JohannesKienle/Messgeraet/Hardware/Ver1/Analogeingaenge.png

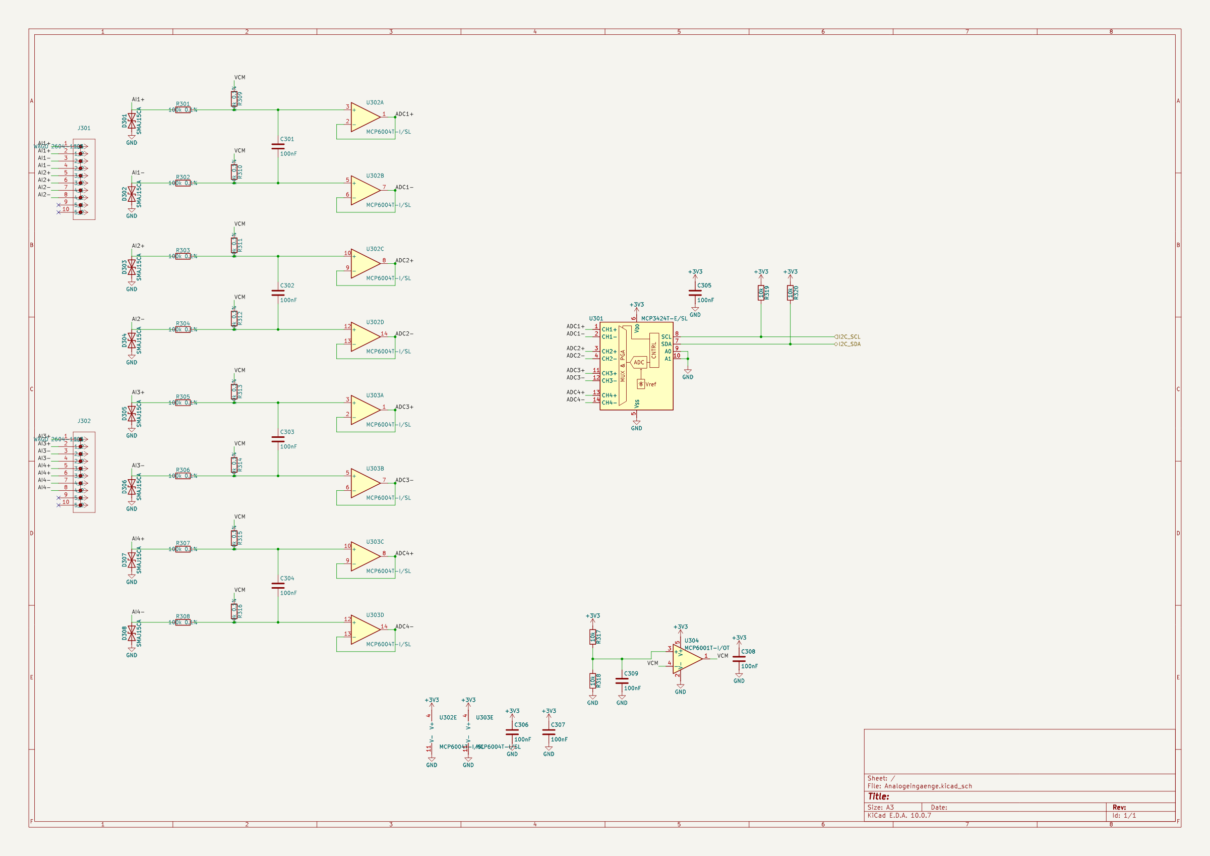
Hardware/Ver1/Analogeingaenge.png
