JohannesKienle/Messgeraet/Hardware/Ver1/Netzspannung.png

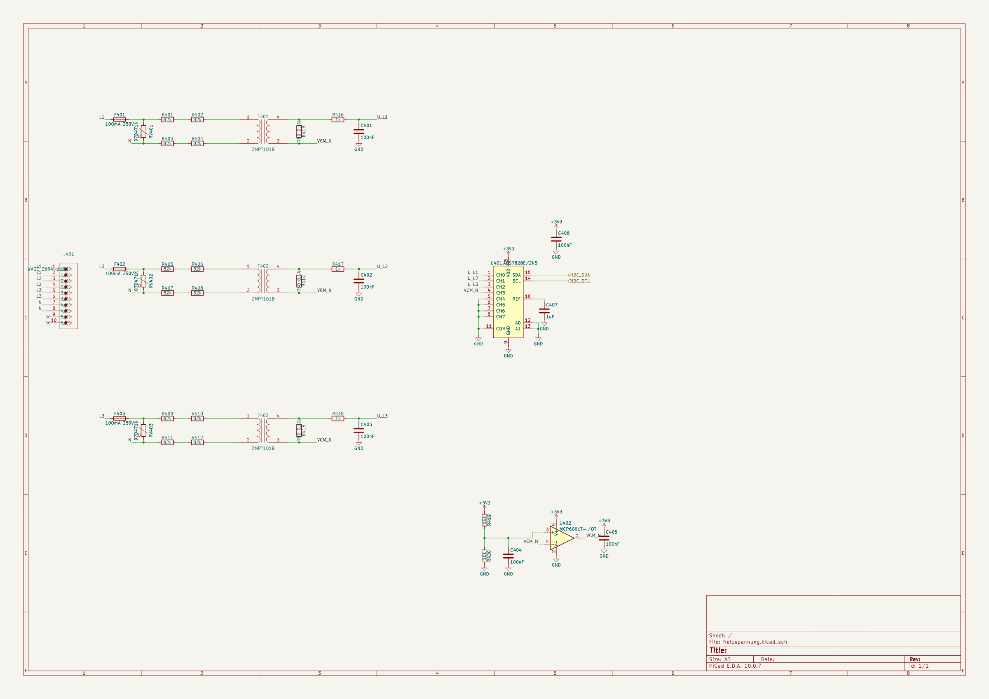
Hardware/Ver1/Netzspannung.png
