JohannesKienle/Messgeraet/Hardware/Ver1/Versorgung.png

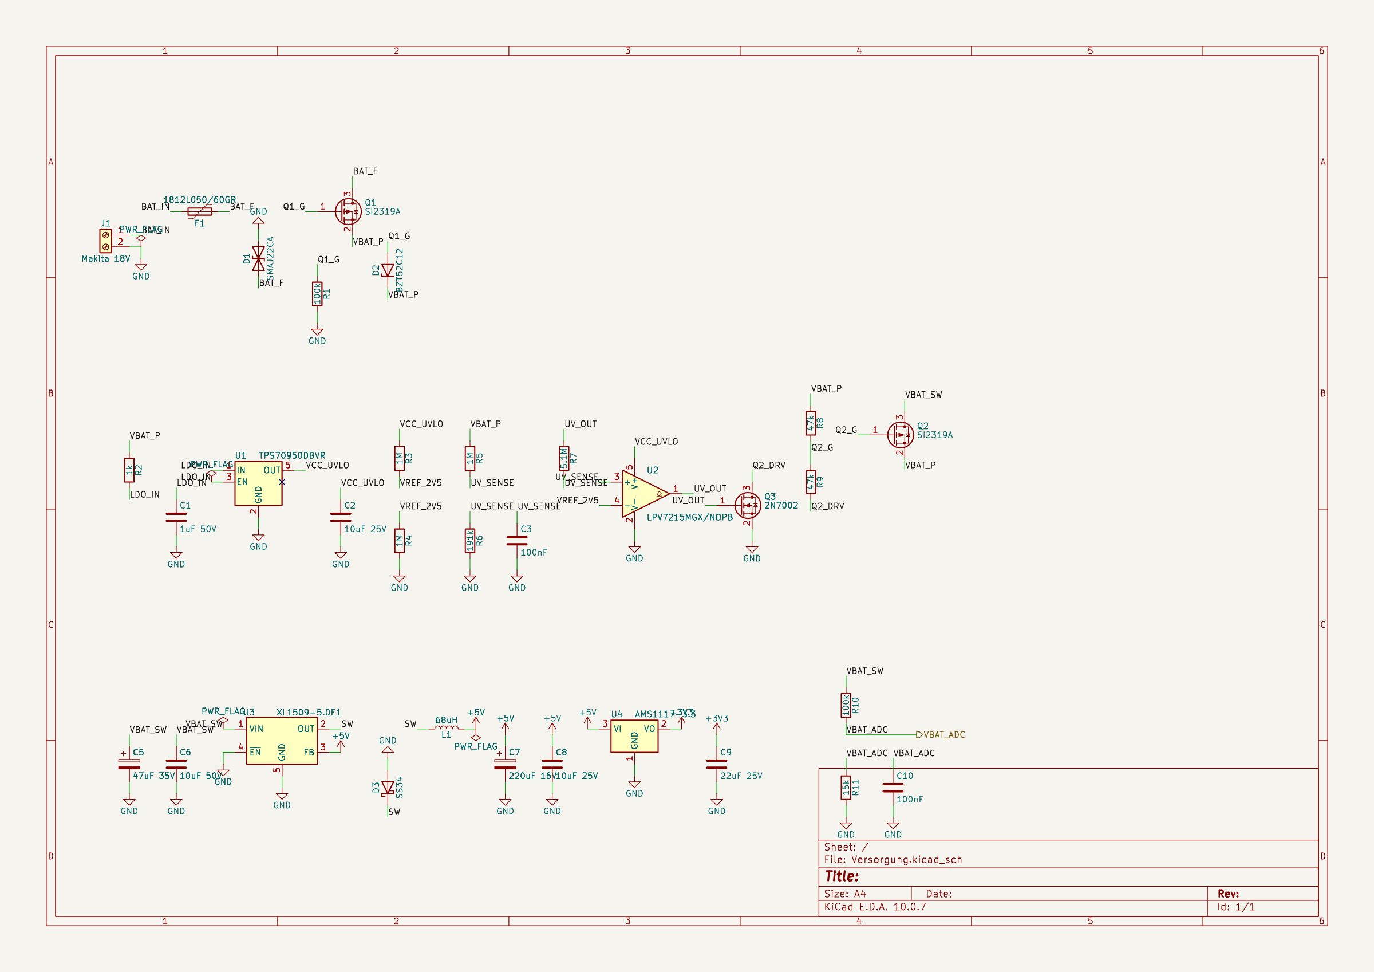
Hardware/Ver1/Versorgung.png
