JohannesKienle/Messgeraet/Hardware/Ver1/production/bom.csv

Designator | Footprint | Quantity | Value | LCSC Part #
C1, C101 | 0805 | 2 | 1uF 50V | C28323
C10, C103, C105, C205, C206, C207, C208, C3, C301, C302, C303, C304, C305, C306, C307, C308, C309, C401, C402, C403, C404, C405, C406, C407 | 0805 | 24 | 100nF | C49678
C102, C9 | 0805 | 2 | 22uF 25V | C45783
C104, C2, C8 | 0805 | 3 | 10uF 25V | C15850
C11 | CP_EIA-3528-21_Kemet-B | 1 | 22uF 10V Tantal | C7198
C201, C202, C203, C204 | 0805 | 4 | 10nF 50V | C1710
C5 | CP_Radial_D6.3mm_P2.50mm | 1 | 47uF 50V | C106605
C6 | 0805 | 1 | 10uF 50V | C440198
C7 | CP_Elec_6.3x7.7 | 1 | 220uF 16V | C178534
D1 | D_SMA | 1 | SMAJ22CA | C113961
D2 | D_SOD-123 | 1 | BZT52C12 | C43491
D201, D202, D203, D204 | D_SMA | 4 | SMAJ30CA | C83322
D205, D206, D207, D208 | 0805 | 4 | gelb | C2296
D3 | D_SMA | 1 | SS34 | C8678
D301, D302, D303, D304, D305, D306, D307, D308 | D_SMA | 8 | SMAJ26CA | C148226
F1 | 1812 | 1 | 1812L050/60GR | C19078719
F401, F402, F403 | Fuse_2410_JDT_JFC2410 | 3 | 100mA 250V | C48686858
J1 | TestPoint_2Pads_Pitch5.08mm_Drill1.3mm | 1 | Makita 18V
J101 | USB_C_Receptacle_HRO_TYPE-C-31-M-12 | 1 | USB-C | C165948
J102 | microSD_HC_Hirose_DM3AT-SF-PEJM5 | 1 | DM3AT-SF-PEJM5 | C114218
J201, J301, J302, J401 | CONN5_2604-1105_WAG | 4 | WAGO 2604-1105 | WAGO 2604-1105
L1 | L_Sunlord_SWPA8040S | 1 | 68uH | C36418
Q1, Q2 | SOT-23 | 2 | SI2319A | C545576
Q3 | SOT-23 | 1 | 2N7002 | C8545
R1, R10 | 0805 | 2 | 100k | C149504
R101, R102, R105, R106, R107, R108, R109, R110, R317, R318, R420 | 0805 | 11 | 10k | C17414
R103, R104 | 0805 | 2 | 5.1k | C27834
R11, R419 | 0805 | 2 | 15k | C17475
R2, R201, R202, R203, R204, R416, R417, R418 | 0805 | 8 | 1k | C17513
R205, R206, R207, R208 | 0805 | 4 | 562 1% | C17755
R209, R210, R211, R212 | 0805 | 4 | 680 | C17798
R3, R4, R5 | 0805 | 3 | 1M | C17514
R301, R302, R303, R304, R305, R306, R307, R308 | 0805 | 8 | 100k 0.1% | C122537
R309, R310, R311, R312, R313, R314, R315, R316 | 0805 | 8 | 10k 0.1% | C110775
R319, R320 | 0805 | 2 | 4.7k | C17673
R401, R402, R403, R404, R405, R406, R407, R408, R409, R410, R411, R412 | 1206 | 12 | 56k | C18029
R413, R414, R415 | 0805 | 3 | 510 0.1% | C309660
R6 | 0805 | 1 | 191k | C17511
R7 | 0805 | 1 | 5.1M | C26114
R8, R9 | 0805 | 2 | 47k | C17713
RV401, RV402, RV403 | RV_Disc_D7mm_W3.4mm_P5mm | 3 | 07D471K | C28756
SW101 | SW_Push_1P1T_XKB_TS-1187A | 1 | RESET | C318884
SW102 | SW_Push_1P1T_XKB_TS-1187A | 1 | BOOT | C318884
T401, T402, T403 | Transformer_Zeming_ZMPT101K | 3 | ZMPT101B | C111858
U1 | SOT-23-5 | 1 | TPS70950DBVR | C96028
U101 | ESP32-S3-WROOM-1 | 1 | ESP32-S3-WROOM-1-N16R8 | C2913202
U102 | SOT-23-6 | 1 | USBLC6-2SC6 | C2687116
U2 | SOT-353_SC-70-5 | 1 | LPV7215MGX/NOPB | C2878861
U201, U202, U203, U204 | SOIC-8_3.9x4.9mm_P1.27mm | 4 | ISO1211DR | C2674102
U3 | SOIC-8_3.9x4.9mm_P1.27mm | 1 | XL1509-5.0E1 | C61063
U301 | SOIC-14_3.9x8.7mm_P1.27mm | 1 | MCP3424T-E/SL | C626769
U302, U303 | SOIC-14_3.9x8.7mm_P1.27mm | 2 | MCP6004T-I/SL | C7378
U304, U402 | SOT-23-5 | 2 | MCP6001T-I/OT | C116490
U4 | SOT-223-3_TabPin2 | 1 | AMS1117-3.3 | C6186
U401 | TSSOP-16_4.4x5mm_P0.65mm | 1 | ADS7828E/2K5 | C701649
