JohannesKienle/Messgeraet/Hardware/Ver1/Manufacturing/Ver1.csv

Id | Designator | Footprint | Quantity | Designation | Supplier and ref
1 | C1, C101 | C_0805_2012Metric | 2 | 1uF 50V
2 | C2, C8, C104 | C_0805_2012Metric | 3 | 10uF 25V
3 | C3, C10, C103, C105, C205, C206, C207, C208, C301, C302, C303, C304, C305, C306, C307, C308, C309, C401, C402, C403, C404, C405, C406, C407 | C_0805_2012Metric | 24 | 100nF
4 | C5 | CP_Radial_D6.3mm_P2.50mm | 1 | 47uF 50V
5 | C6 | C_0805_2012Metric | 1 | 10uF 50V
6 | C7 | CP_Elec_6.3x7.7 | 1 | 220uF 16V
7 | C9, C102 | C_0805_2012Metric | 2 | 22uF 25V
8 | C11 | CP_EIA-3528-21_Kemet-B | 1 | 22uF 10V Tantal
9 | C201, C202, C203, C204 | C_0805_2012Metric | 4 | 10nF 50V
10 | D1 | D_SMA | 1 | SMAJ22CA
11 | D2 | D_SOD-123 | 1 | BZT52C12
12 | D3 | D_SMA | 1 | SS34
13 | D201, D202, D203, D204 | D_SMA | 4 | SMAJ30A
14 | D205, D206, D207, D208 | LED_0805_2012Metric | 4 | gelb
15 | D301, D302, D303, D304, D305, D306, D307, D308 | D_SMA | 8 | SMAJ26CA
16 | F1 | Fuse_1812_4532Metric | 1 | 1812L050/60GR
17 | F401, F402, F403 | Fuse_2410_JDT_JFC2410 | 3 | 100mA 250V
18 | J1 | TestPoint_2Pads_Pitch5.08mm_Drill1.3mm | 1 | Makita 18V
19 | J101 | USB_C_Receptacle_HRO_TYPE-C-31-M-12 | 1 | USB-C
20 | J102 | microSD_HC_Hirose_DM3AT-SF-PEJM5 | 1 | DM3AT-SF-PEJM5
21 | J201, J301, J302, J401 | CONN5_2604-1105_WAG | 4 | WAGO 2604-1105
22 | L1 | L_Sunlord_SWPA8040S | 1 | 68uH
23 | Q1, Q2 | SOT-23 | 2 | SI2319A
24 | Q3 | SOT-23 | 1 | 2N7002
25 | R1, R10 | R_0805_2012Metric | 2 | 100k
26 | R2, R201, R202, R203, R204, R416, R417, R418 | R_0805_2012Metric | 8 | 1k
27 | R3, R4, R5 | R_0805_2012Metric | 3 | 1M
28 | R6 | R_0805_2012Metric | 1 | 191k
29 | R7 | R_0805_2012Metric | 1 | 5.1M
30 | R8, R9 | R_0805_2012Metric | 2 | 47k
31 | R11, R419 | R_0805_2012Metric | 2 | 15k
32 | R101, R102, R105, R106, R107, R108, R109, R110, R317, R318, R420 | R_0805_2012Metric | 11 | 10k
33 | R103, R104 | R_0805_2012Metric | 2 | 5.1k
34 | R205, R206, R207, R208 | R_0805_2012Metric | 4 | 562 1%
35 | R209, R210, R211, R212 | R_0805_2012Metric | 4 | 680
36 | R301, R302, R303, R304, R305, R306, R307, R308 | R_0805_2012Metric | 8 | 100k 0.1%
37 | R309, R310, R311, R312, R313, R314, R315, R316 | R_0805_2012Metric | 8 | 10k 0.1%
38 | R319, R320 | R_0805_2012Metric | 2 | 4.7k
39 | R401, R402, R403, R404, R405, R406, R407, R408, R409, R410, R411, R412 | R_1206_3216Metric | 12 | 82k
40 | R413, R414, R415 | R_0805_2012Metric | 3 | 750 0.1%
41 | RV401, RV402, RV403 | RV_Disc_D7mm_W3.4mm_P5mm | 3 | 07D471K
42 | SW101 | SW_Push_1P1T_XKB_TS-1187A | 1 | RESET
43 | SW102 | SW_Push_1P1T_XKB_TS-1187A | 1 | BOOT
44 | T401, T402, T403 | Transformer_Zeming_ZMPT101K | 3 | ZMPT101B
45 | U1 | SOT-23-5 | 1 | TPS70950DBVR
46 | U2 | SOT-353_SC-70-5 | 1 | LPV7215MGX/NOPB
47 | U3 | SOIC-8_3.9x4.9mm_P1.27mm | 1 | XL1509-5.0E1
48 | U4 | SOT-223-3_TabPin2 | 1 | AMS1117-3.3
49 | U101 | ESP32-S3-WROOM-1 | 1 | ESP32-S3-WROOM-1-N16R8
50 | U102 | SOT-23-6 | 1 | USBLC6-2SC6
51 | U201, U202, U203, U204 | SOIC-8_3.9x4.9mm_P1.27mm | 4 | ISO1211DR
52 | U301 | SOIC-14_3.9x8.7mm_P1.27mm | 1 | MCP3424T-E/SL
53 | U302, U303 | SOIC-14_3.9x8.7mm_P1.27mm | 2 | MCP6004T-I/SL
54 | U304, U402 | SOT-23-5 | 2 | MCP6001T-I/OT
55 | U401 | TSSOP-16_4.4x5mm_P0.65mm | 1 | ADS7828E/2K5
