JohannesKienle/Messgeraet/Hardware/Ver1/KiCADv6/2604-1105.stp

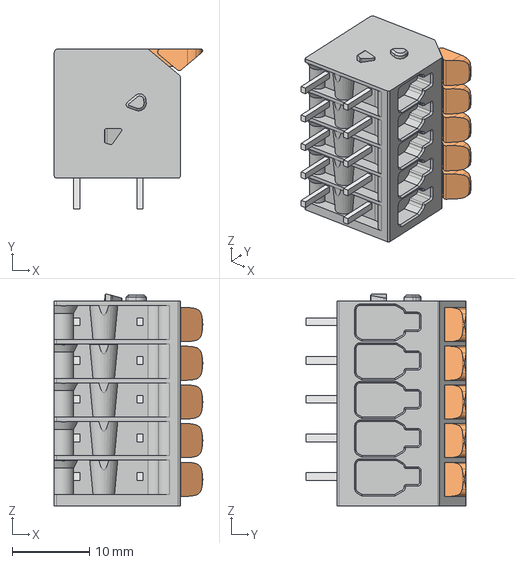
[picture p4: CAD file, 2026-11-12]
Hardware/Ver1/KiCADv6/2604-1105.stp
19.2 x 20.7 x 27.4 mm
