JohannesKienle/Messgeraet/Hardware/Ver1/Ver1.step

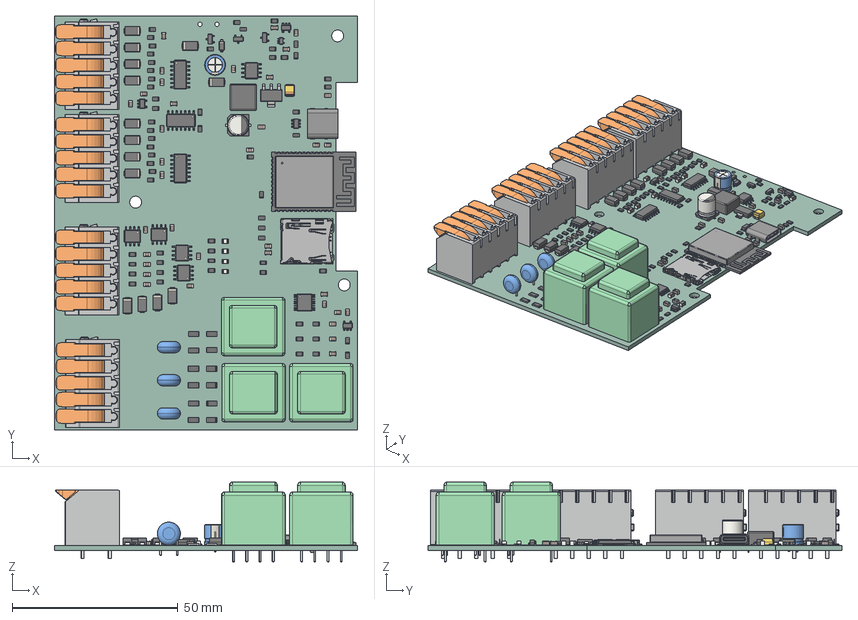
[picture p5: CAD file, 2026-11-12]
Hardware/Ver1/Ver1.step
91.5 x 125.0 x 24.1 mm
C_0805_2012Metric x 36
R_0805_2012Metric x 61
R_1206_3216Metric x 12
ESP32-S3-WROOM-1
SOT-353_SC-70-5
D_SMA x 14
SOIC-14_3.9x8.7mm_P1.27mm x 3
RV_Disc_D7mm_W34mm_P5mm x 3
Transformer_Breve_TEZ_22x025 x 3
Transformer_Breve_TEZ_22x24 x 3
CP_Elec_63x77
SOT-23-5 x 3
LED_0805_2012Metric x 4
SOIC-8_3.9x4.9mm_P1.27mm x 5
USB_C_Receptacle_GCT_USB4085
SOT-23 x 3
SOT-223
a6ca55be-8551-11ed-a139-00155d22e2d7_part
a6ca56f4-8551-11ed-a139-00155d22e2d7_part
a6ca5776-8551-11ed-a139-00155d22e2d7_part
CP_EIA_3528_21_Kemet_B
TSSOP-16_4.4x5mm_P0.65mm
microSD_HC_Hirose_DM3AT-SF-PEJM5
D_SOD-123
SOT-23-6
CP_Radial_D63mm_P250mm
Ver81F1_PCB
