JohannesKienle/Messgeraet/Hardware/Ver1/Ver1.kicad_pcb

## KiCad design Hardware/Ver1/Ver1.kicad_pcb (2026-11-12)

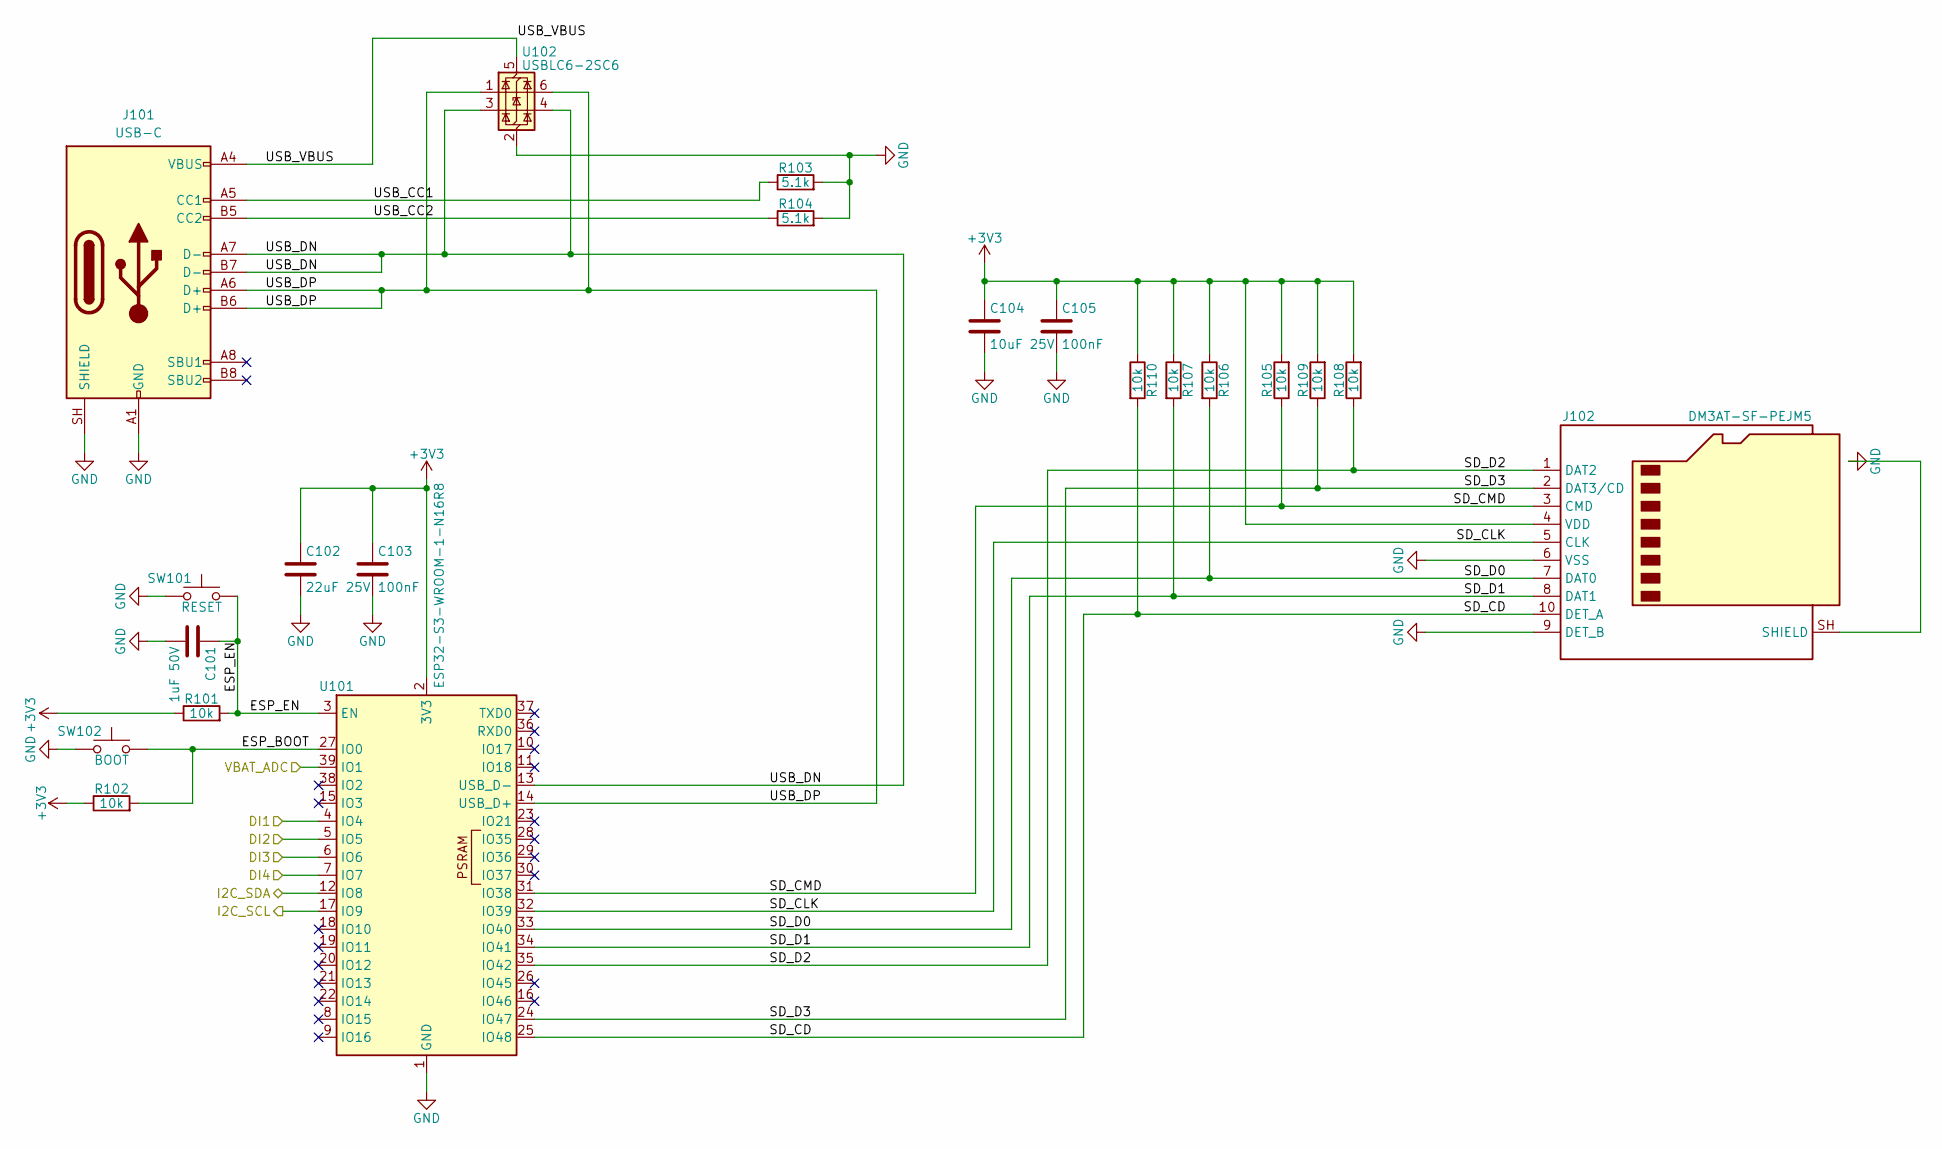
[picture p6: schematic ESP32.kicad_sch]

Parts:
C101: 1uF 50V; C_0805_2012Metric; MPN CL21B105KBFNNNE; LCSC C28323
C102: 22uF 25V; C_0805_2012Metric; MPN CL21A226MAQNNNE; LCSC C45783
C103, C105: 100nF; C_0805_2012Metric; MPN CC0805KRX7R9BB104; LCSC C49678
C104: 10uF 25V; C_0805_2012Metric; MPN CL21A106KAYNNNE; LCSC C15850
J101: USB-C; USB_C_Receptacle_HRO_TYPE-C-31-M-12; MPN TYPE-C-31-M-12; LCSC C165948
J102: DM3AT-SF-PEJM5; microSD_HC_Hirose_DM3AT-SF-PEJM5; MPN DM3AT-SF-PEJM5; LCSC C114218
R101, R102, R105, R106, R107, R108, R109, R110: 10k; R_0805_2012Metric; MPN 0805W8F1002T5E; LCSC C17414
R103, R104: 5.1k; R_0805_2012Metric; MPN 0805W8F5101T5E; LCSC C27834
SW101: RESET; SW_Push_1P1T_XKB_TS-1187A; MPN TS-1187A-B-A-B; LCSC C318884
SW102: BOOT; SW_Push_1P1T_XKB_TS-1187A; MPN TS-1187A-B-A-B; LCSC C318884
U101: ESP32-S3-WROOM-1-N16R8; ESP32-S3-WROOM-1; MPN ESP32-S3-WROOM-1-N16R8; LCSC C2913202
U102: USBLC6-2SC6; SOT-23-6; MPN USBLC6-2SC6; LCSC C2687116

Connections:
+3V3: C102.1, C103.1, C104.1, C105.1, J102.4 (VDD), R101.1, R102.1, R105.2, R106.1, R107.1, R108.2, R109.2, R110.1, U101.2 (3V3); also elsewhere on the board
/Analogeingänge/I2C_SCL: U101.17 (IO9); also elsewhere on the board
/Analogeingänge/I2C_SDA: U101.12 (IO8); also elsewhere on the board
/Digitaleingänge/DI1: U101.4 (IO4); also elsewhere on the board
/Digitaleingänge/DI2: U101.5 (IO5); also elsewhere on the board
/Digitaleingänge/DI3: U101.6 (IO6); also elsewhere on the board
/Digitaleingänge/DI4: U101.7 (IO7); also elsewhere on the board
/ESP32/ESP_BOOT: R102.2, SW102.1, U101.27 (IO0)
/ESP32/ESP_EN: C101.1, R101.2, SW101.1, U101.3 (EN)
/ESP32/SD_CD: J102.10 (DET_A), R110.2, U101.25 (IO48)
/ESP32/SD_CLK: J102.5 (CLK), U101.32 (IO39)
/ESP32/SD_CMD: J102.3 (CMD), R105.1, U101.31 (IO38)
/ESP32/SD_D0: J102.7 (DAT0), R106.2, U101.33 (IO40)
/ESP32/SD_D1: J102.8 (DAT1), R107.2, U101.34 (IO41)
/ESP32/SD_D2: J102.1 (DAT2), R108.1, U101.35 (IO42)
/ESP32/SD_D3: J102.2 (DAT3/CD), R109.1, U101.24 (IO47)
/ESP32/USB_CC1: J101.A5 (CC1), R103.1
/ESP32/USB_CC2: J101.B5 (CC2), R104.1
/ESP32/USB_DN: J101.A7 (D-), J101.B7 (D-), U101.13 (USB_D-), U102.3 (I/O2), U102.4 (I/O2)
/ESP32/USB_DP: J101.A6 (D+), J101.B6 (D+), U101.14 (USB_D+), U102.1 (I/O1), U102.6 (I/O1)
/ESP32/USB_VBUS: J101.A4 (VBUS), J101.A9 (VBUS), J101.B4 (VBUS), J101.B9 (VBUS), U102.5 (VBUS)
/Versorgung/VBAT_ADC: U101.39 (IO1); also elsewhere on the board

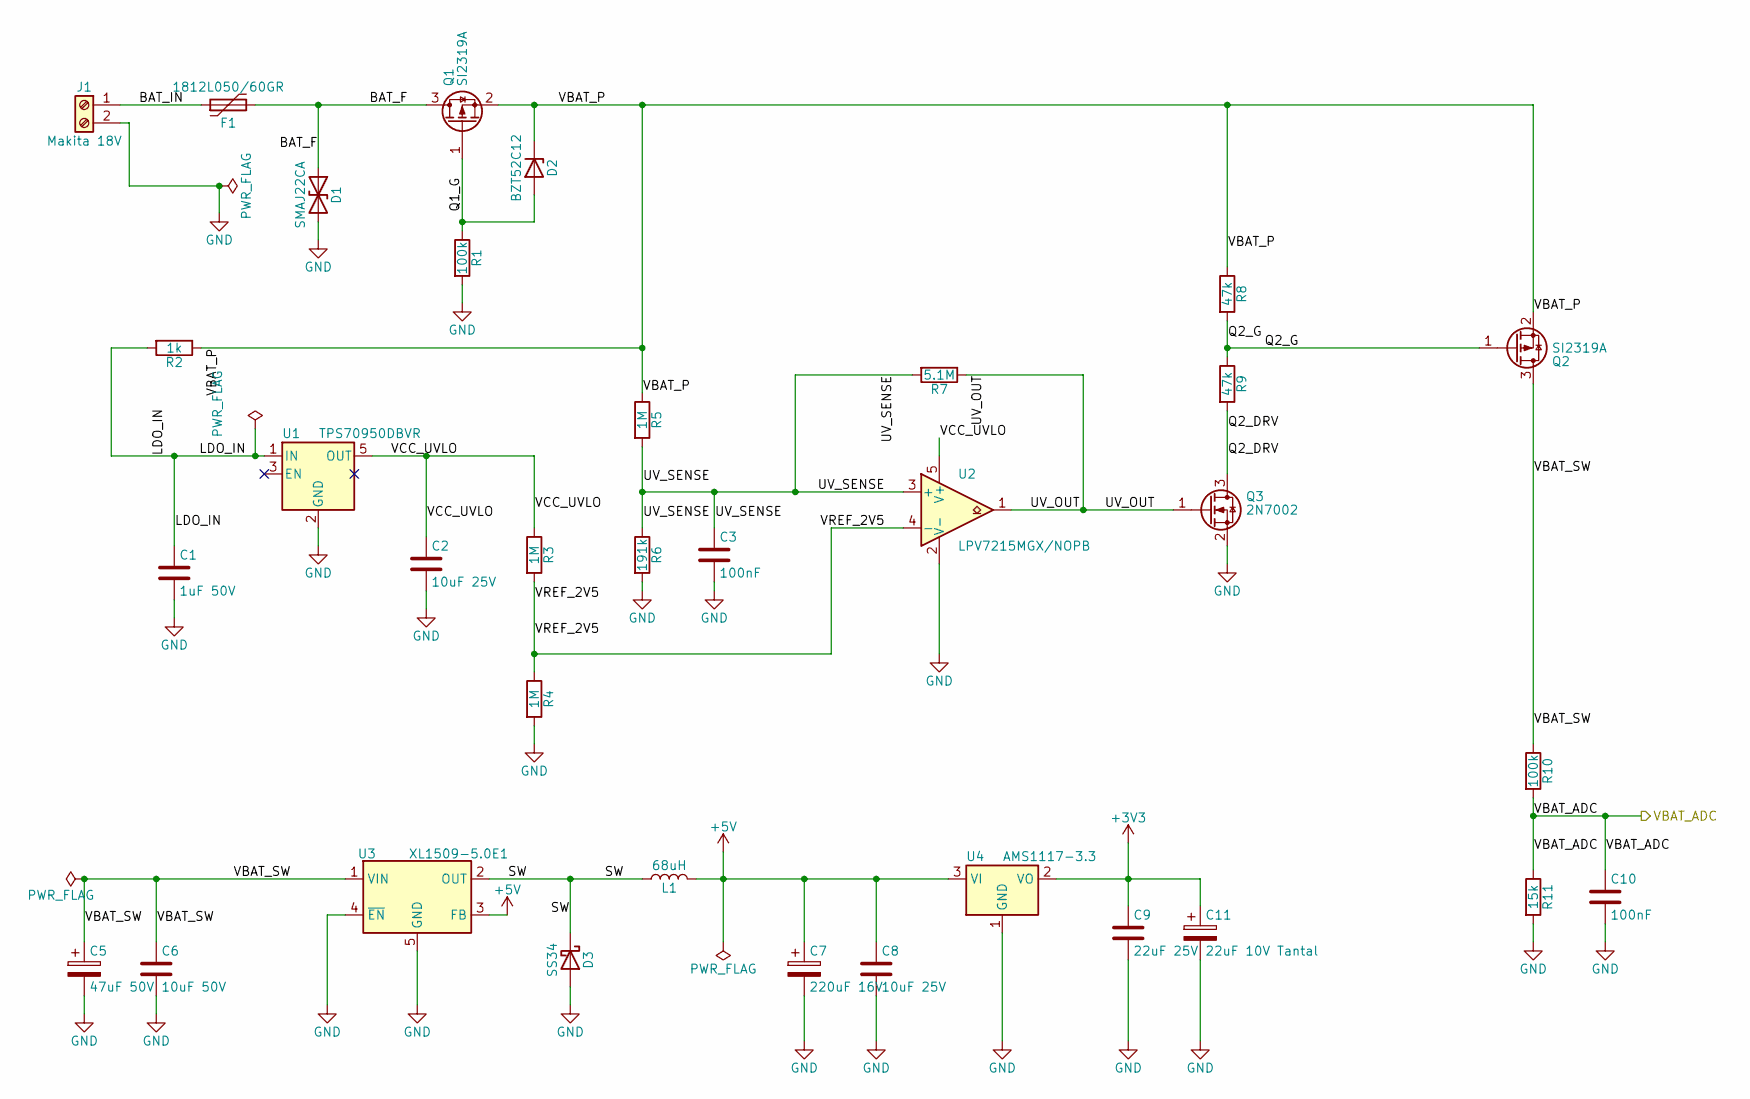
[picture p7: schematic Versorgung.kicad_sch]

Parts:
C1: 1uF 50V; C_0805_2012Metric; MPN CL21B105KBFNNNE; LCSC C28323
C2, C8: 10uF 25V; C_0805_2012Metric; MPN CL21A106KAYNNNE; LCSC C15850
C3, C10: 100nF; C_0805_2012Metric; MPN CC0805KRX7R9BB104; LCSC C49678
C5: 47uF 50V; CP_Radial_D6.3mm_P2.50mm; MPN ERM1HM470E11OT; LCSC C106605
C6: 10uF 50V; C_0805_2012Metric; MPN GRM21BR61H106KE43L; LCSC C440198
C7: 220uF 16V; CP_Elec_6.3x7.7; MPN EEEFK1C221P; LCSC C178534
C9: 22uF 25V; C_0805_2012Metric; MPN CL21A226MAQNNNE; LCSC C45783
C11: 22uF 10V Tantal; CP_EIA-3528-21_Kemet-B; MPN TAJB226K010RNJ; LCSC C7198
D1: SMAJ22CA; D_SMA; MPN SMAJ22CA; LCSC C113961
D2: BZT52C12; D_SOD-123; MPN BZT52C12; LCSC C43491
D3: SS34; D_SMA; MPN SS34; LCSC C8678
F1: 1812L050/60GR; Fuse_1812_4532Metric; MPN 1812L050/60GR; LCSC C19078719
J1: Makita 18V; TestPoint_2Pads_Pitch5.08mm_Drill1.3mm
L1: 68uH; L_Sunlord_SWPA8040S; MPN SWPA8040S680MT; LCSC C36418
Q1, Q2: SI2319A; SOT-23; MPN SI2319A; LCSC C545576
Q3: 2N7002; SOT-23; MPN 2N7002; LCSC C8545
R1, R10: 100k; R_0805_2012Metric; MPN 0805W8F1003T5E; LCSC C149504
R2: 1k; R_0805_2012Metric; MPN 0805W8F1001T5E; LCSC C17513
R3, R4, R5: 1M; R_0805_2012Metric; MPN 0805W8F1004T5E; LCSC C17514
R6: 191k; R_0805_2012Metric; MPN 0805W8F1913T5E; LCSC C17511
R7: 5.1M; R_0805_2012Metric; MPN 0805W8F5104T5E; LCSC C26114
R8, R9: 47k; R_0805_2012Metric; MPN 0805W8F4702T5E; LCSC C17713
R11: 15k; R_0805_2012Metric; MPN 0805W8F1502T5E; LCSC C17475
U1: TPS70950DBVR; SOT-23-5; MPN TPS70950DBVR; LCSC C96028
U2: LPV7215MGX/NOPB; SOT-353_SC-70-5; MPN LPV7215MGX/NOPB; LCSC C2878861
U3: XL1509-5.0E1; SOIC-8_3.9x4.9mm_P1.27mm; MPN XL1509-5.0E1; LCSC C61063
U4: AMS1117-3.3; SOT-223-3_TabPin2; MPN AMS1117-3.3; LCSC C6186

Connections:
+3V3: C9.1, C11.1, U4.2 (VO); also elsewhere on the board
/Versorgung/BAT_F: D1.1 (A1), F1.2, Q1.3 (D)
/Versorgung/BAT_IN: F1.1, J1.1
/Versorgung/Q1_G: D2.2 (A), Q1.1 (G), R1.1
/Versorgung/Q2_DRV: Q3.3 (D), R9.2
/Versorgung/Q2_G: Q2.1 (G), R8.2, R9.1
/Versorgung/SW: D3.1 (K), L1.1, U3.2 (OUT)
/Versorgung/UV_OUT: Q3.1 (G), R7.1, U2.1
/Versorgung/UV_SENSE: C3.1, R5.2, R6.1, R7.2, U2.3 (+)
/Versorgung/VBAT_ADC: C10.1, R10.2, R11.1; also elsewhere on the board
/Versorgung/VBAT_P: D2.1 (K), Q1.2 (S), Q2.2 (S), R2.1, R5.1, R8.1
/Versorgung/VCC_UVLO: C2.1, R3.1, U1.5 (OUT), U2.5 (V+)
/Versorgung/VREF_2V5: R3.2, R4.1, U2.4 (-)

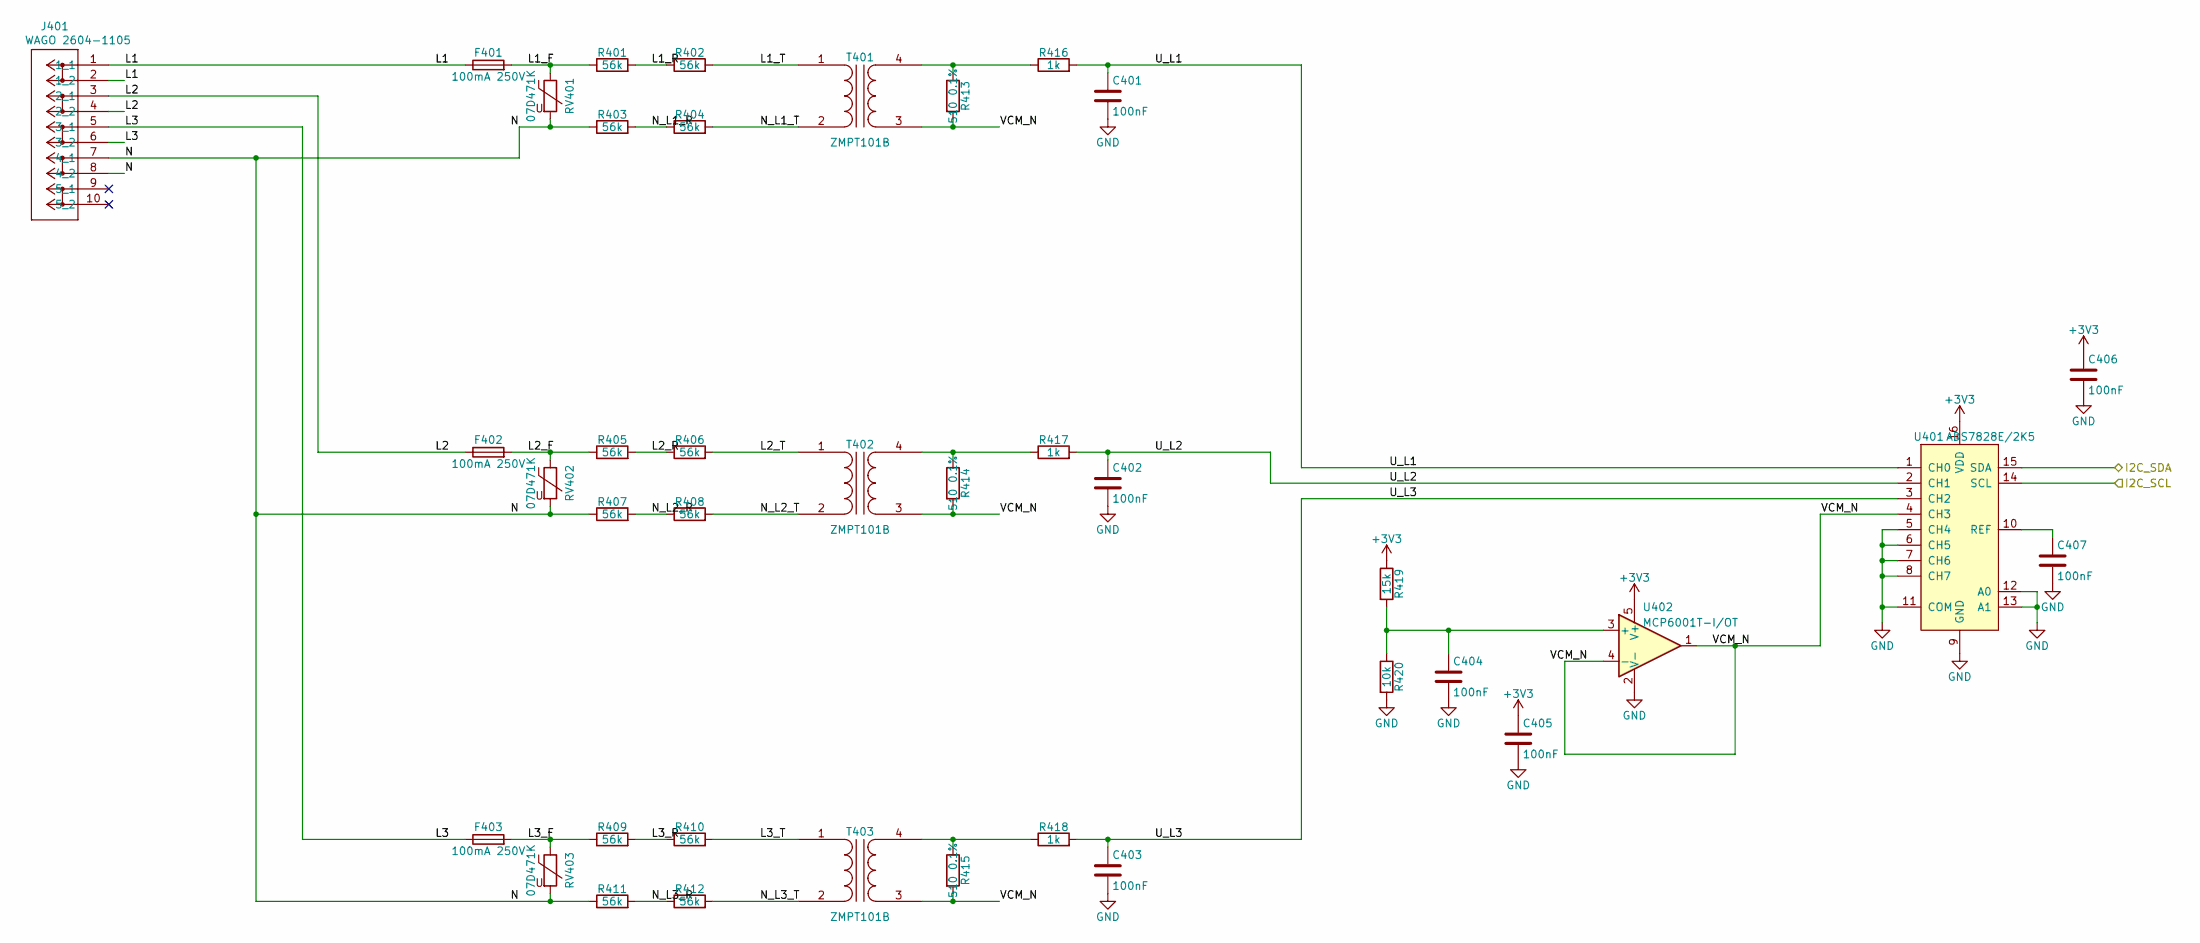
[picture p8: schematic Netzspannung.kicad_sch]

Parts:
C401, C402, C403, C404, C405, C406, C407: 100nF; C_0805_2012Metric; MPN CC0805KRX7R9BB104; LCSC C49678
F401, F402, F403: 100mA 250V; Fuse_2410_JDT_JFC2410; MPN JFC2410-0100FS; LCSC C48686858
J401: WAGO 2604-1105; CONN5_2604-1105_WAG; MPN WAGO 2604-1105
R401, R402, R403, R404, R405, R406, R407, R408, R409, R410, R411, R412: 56k; R_1206_3216Metric; MPN 1206W4F5602T5E; LCSC C18029
R413, R414, R415: 510 0.1%; R_0805_2012Metric; MPN RT0805BRD07510RL; LCSC C309660
R416, R417, R418: 1k; R_0805_2012Metric; MPN 0805W8F1001T5E; LCSC C17513
R419: 15k; R_0805_2012Metric; MPN 0805W8F1502T5E; LCSC C17475
R420: 10k; R_0805_2012Metric; MPN 0805W8F1002T5E; LCSC C17414
RV401, RV402, RV403: 07D471K; RV_Disc_D7mm_W3.4mm_P5mm; MPN 07D471K; LCSC C28756
T401, T402, T403: ZMPT101B; Transformer_Zeming_ZMPT101K; MPN ZMPT101B; LCSC C111858
U401: ADS7828E/2K5; TSSOP-16_4.4x5mm_P0.65mm; MPN ADS7828E/2K5; LCSC C701649
U402: MCP6001T-I/OT; SOT-23-5; MPN MCP6001T-I/OT; LCSC C116490

Connections:
+3V3: C405.1, C406.1, R419.1, U401.16 (VDD), U402.5 (V+); also elsewhere on the board
/Analogeingänge/I2C_SCL: U401.14 (SCL); also elsewhere on the board
/Analogeingänge/I2C_SDA: U401.15 (SDA); also elsewhere on the board
/Netzspannung/L1: F401.1, J401.1 (1_1), J401.2 (1_2)
/Netzspannung/L1_F: F401.2, R401.1, RV401.1
/Netzspannung/L1_R: R401.2, R402.1
/Netzspannung/L1_T: R402.2, T401.1 (AA)
/Netzspannung/L2: F402.1, J401.3 (2_1), J401.4 (2_2)
/Netzspannung/L2_F: F402.2, R405.1, RV402.1
/Netzspannung/L2_R: R405.2, R406.1
/Netzspannung/L2_T: R406.2, T402.1 (AA)
/Netzspannung/L3: F403.1, J401.5 (3_1), J401.6 (3_2)
/Netzspannung/L3_F: F403.2, R409.1, RV403.1
/Netzspannung/L3_R: R409.2, R410.1
/Netzspannung/L3_T: R410.2, T403.1 (AA)
/Netzspannung/N: J401.7 (4_1), J401.8 (4_2), R403.1, R407.1, R411.1, RV401.2, RV402.2, RV403.2
/Netzspannung/N_L1_R: R403.2, R404.1
/Netzspannung/N_L1_T: R404.2, T401.2 (AB)
/Netzspannung/N_L2_R: R407.2, R408.1
/Netzspannung/N_L2_T: R408.2, T402.2 (AB)
/Netzspannung/N_L3_R: R411.2, R412.1
/Netzspannung/N_L3_T: R412.2, T403.2 (AB)
/Netzspannung/U_L1: C401.1, R416.2, U401.1 (CH0)
/Netzspannung/U_L2: C402.1, R417.2, U401.2 (CH1)
/Netzspannung/U_L3: C403.1, R418.2, U401.3 (CH2)
/Netzspannung/VCM_N: R413.2, R414.2, R415.2, T401.3 (SA), T402.3 (SA), T403.3 (SA), U401.4 (CH3), U402.1, U402.4 (-)
unnamed: R413.1, R416.1, T401.4 (SB)
unnamed: R414.1, R417.1, T402.4 (SB)
unnamed: R415.1, R418.1, T403.4 (SB)
unnamed: C407.1, U401.10 (REF)
unnamed: C404.1, R419.2, R420.1, U402.3 (+)

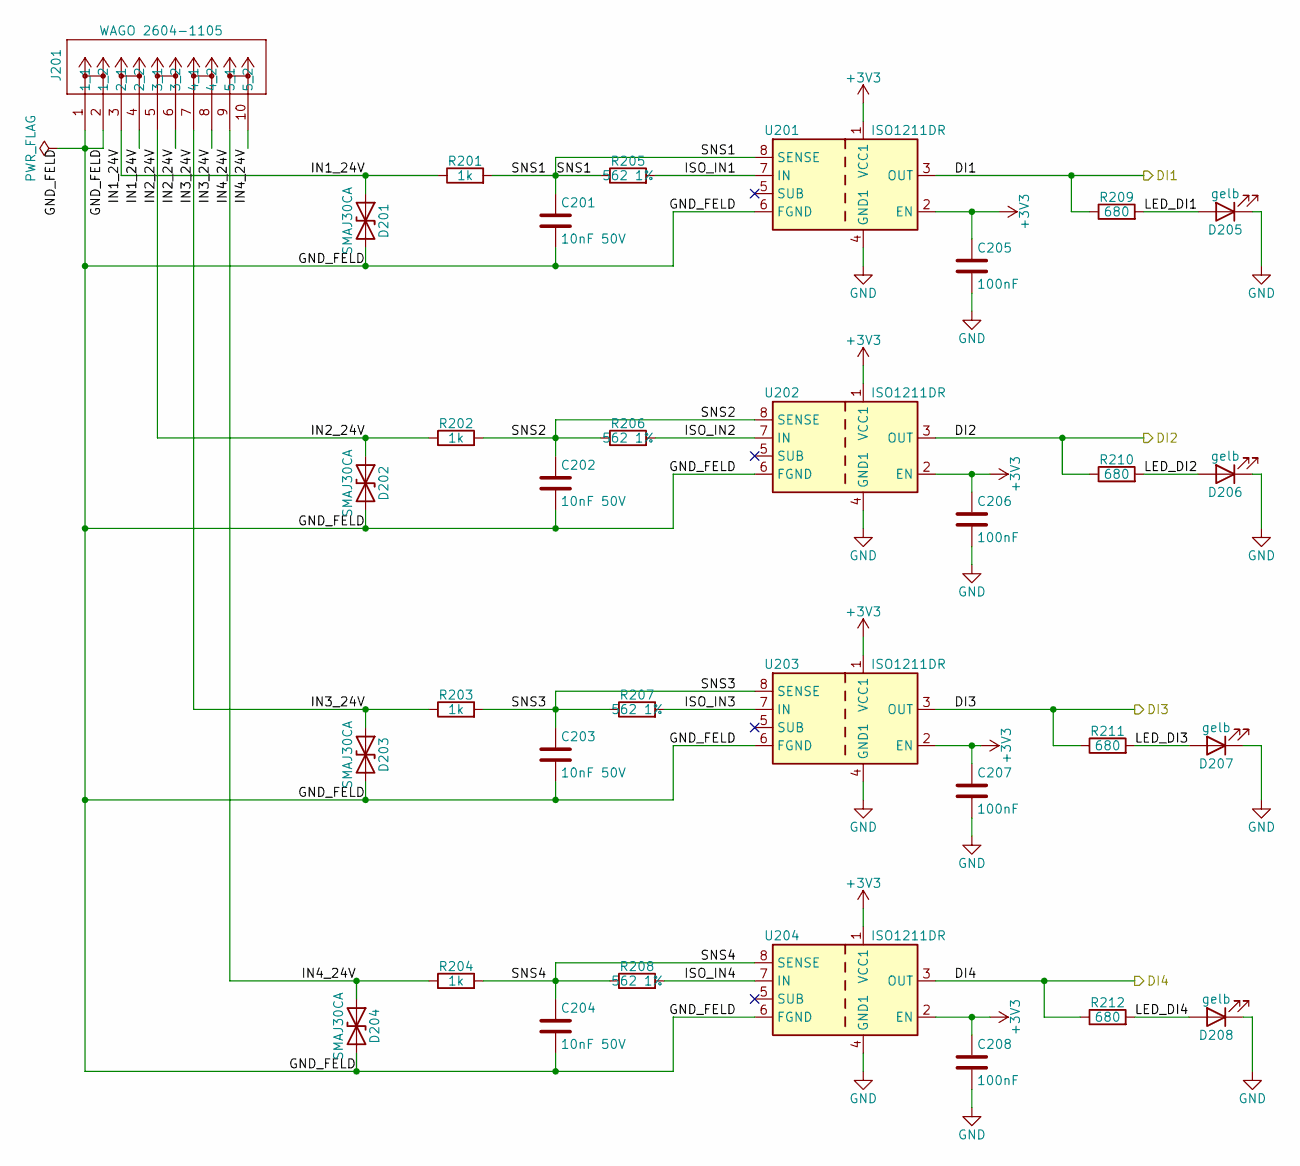
[picture p9: schematic Digitaleingaenge.kicad_sch]

Parts:
C201, C202, C203, C204: 10nF 50V; C_0805_2012Metric; MPN CL21B103KBANNNC; LCSC C1710
C205, C206, C207, C208: 100nF; C_0805_2012Metric; MPN CC0805KRX7R9BB104; LCSC C49678
D201, D202, D203, D204: SMAJ30CA; D_SMA; MPN SMAJ30CA; LCSC C83322
D205, D206, D207, D208: gelb; LED_0805_2012Metric; MPN KT-0805Y; LCSC C2296
J201: WAGO 2604-1105; CONN5_2604-1105_WAG; MPN WAGO 2604-1105
R201, R202, R203, R204: 1k; R_0805_2012Metric; MPN 0805W8F1001T5E; LCSC C17513
R205, R206, R207, R208: 562 1%; R_0805_2012Metric; MPN 0805W8F5620T5E; LCSC C17755
R209, R210, R211, R212: 680; R_0805_2012Metric; MPN 0805W8F6800T5E; LCSC C17798
U201, U202, U203, U204: ISO1211DR; SOIC-8_3.9x4.9mm_P1.27mm; MPN ISO1211DR; LCSC C2674102

Connections:
+3V3: C205.1, C206.1, C207.1, C208.1, U201.1 (VCC1), U201.2 (EN), U202.1 (VCC1), U202.2 (EN), U203.1 (VCC1), U203.2 (EN), U204.1 (VCC1), U204.2 (EN); also elsewhere on the board
/Digitaleingänge/DI1: R209.1, U201.3 (OUT); also elsewhere on the board
/Digitaleingänge/DI2: R210.1, U202.3 (OUT); also elsewhere on the board
/Digitaleingänge/DI3: R211.1, U203.3 (OUT); also elsewhere on the board
/Digitaleingänge/DI4: R212.1, U204.3 (OUT); also elsewhere on the board
/Digitaleingänge/GND_FELD: C201.2, C202.2, C203.2, C204.2, D201.2 (A2), D202.2 (A2), D203.2 (A2), D204.2 (A2), J201.1 (1_1), J201.2 (1_2), U201.6 (FGND), U202.6 (FGND), U203.6 (FGND), U204.6 (FGND)
/Digitaleingänge/IN1_24V: D201.1 (A1), J201.3 (2_1), J201.4 (2_2), R201.1
/Digitaleingänge/IN2_24V: D202.1 (A1), J201.5 (3_1), J201.6 (3_2), R202.1
/Digitaleingänge/IN3_24V: D203.1 (A1), J201.7 (4_1), J201.8 (4_2), R203.1
/Digitaleingänge/IN4_24V: D204.1 (A1), J201.9 (5_1), J201.10 (5_2), R204.1
/Digitaleingänge/ISO_IN1: R205.2, U201.7 (IN)
/Digitaleingänge/ISO_IN2: R206.2, U202.7 (IN)
/Digitaleingänge/ISO_IN3: R207.2, U203.7 (IN)
/Digitaleingänge/ISO_IN4: R208.2, U204.7 (IN)
/Digitaleingänge/LED_DI1: D205.2 (A), R209.2
/Digitaleingänge/LED_DI2: D206.2 (A), R210.2
/Digitaleingänge/LED_DI3: D207.2 (A), R211.2
/Digitaleingänge/LED_DI4: D208.2 (A), R212.2
/Digitaleingänge/SNS1: C201.1, R201.2, R205.1, U201.8 (SENSE)
/Digitaleingänge/SNS2: C202.1, R202.2, R206.1, U202.8 (SENSE)
/Digitaleingänge/SNS3: C203.1, R203.2, R207.1, U203.8 (SENSE)
/Digitaleingänge/SNS4: C204.1, R204.2, R208.1, U204.8 (SENSE)

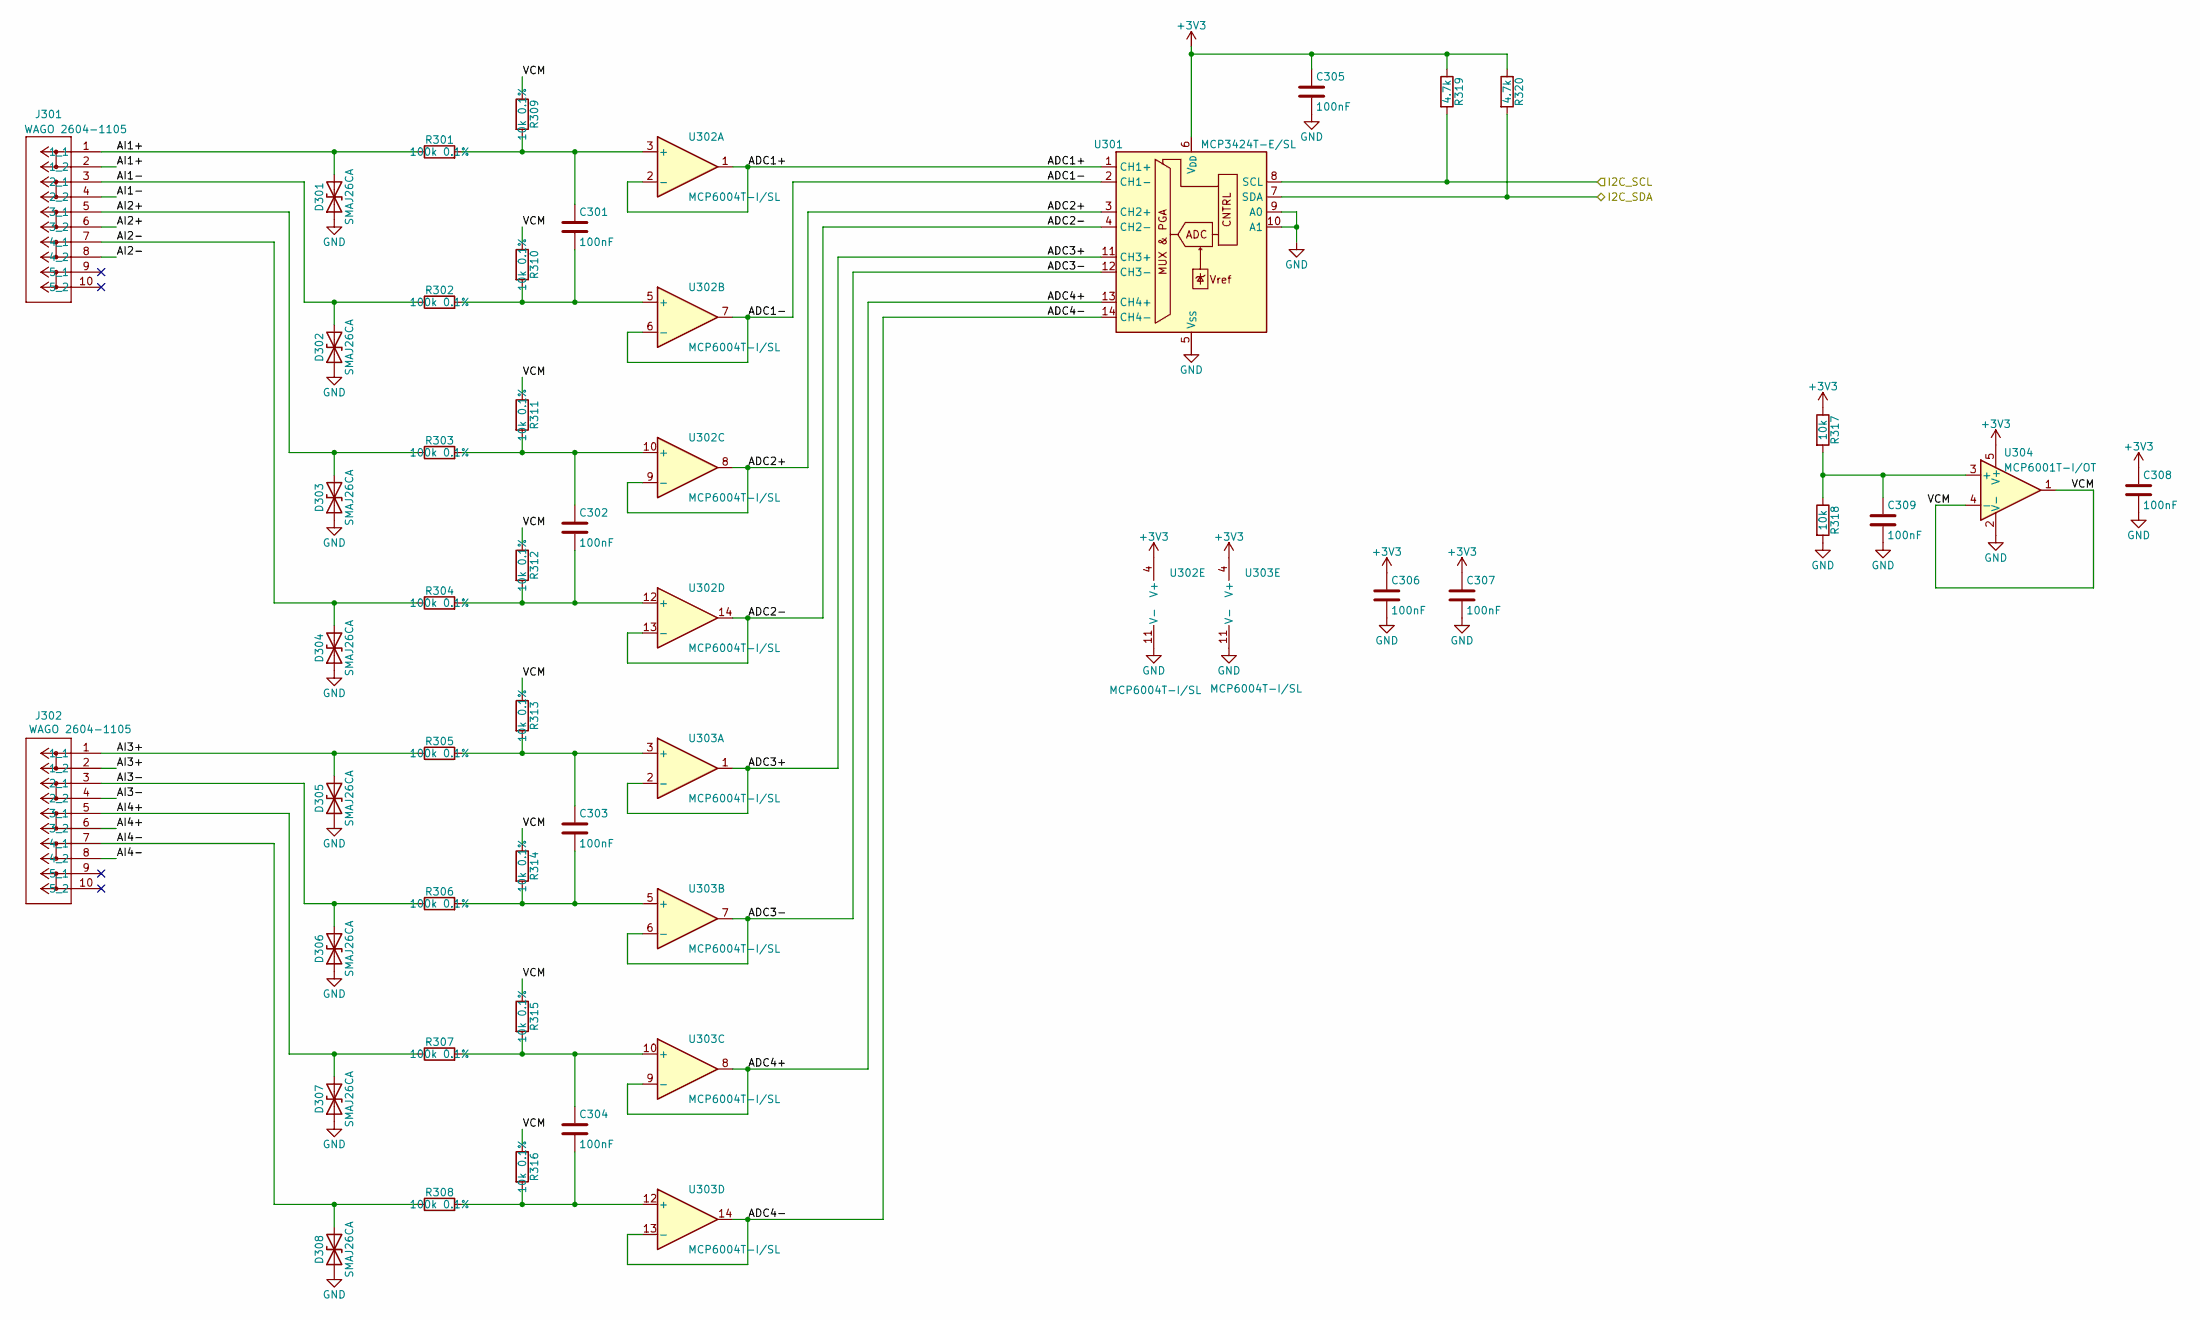
[picture p10: schematic Analogeingaenge.kicad_sch]

Parts:
C301, C302, C303, C304, C305, C306, C307, C308, C309: 100nF; C_0805_2012Metric; MPN CC0805KRX7R9BB104; LCSC C49678
D301, D302, D303, D304, D305, D306, D307, D308: SMAJ26CA; D_SMA; MPN SMAJ26CA; LCSC C148226
J301, J302: WAGO 2604-1105; CONN5_2604-1105_WAG; MPN WAGO 2604-1105
R301, R302, R303, R304, R305, R306, R307, R308: 100k 0.1%; R_0805_2012Metric; MPN RT0805BRD07100KL; LCSC C122537
R309, R310, R311, R312, R313, R314, R315, R316: 10k 0.1%; R_0805_2012Metric; MPN RT0805BRD0710KL; LCSC C110775
R317, R318: 10k; R_0805_2012Metric; MPN 0805W8F1002T5E; LCSC C17414
R319, R320: 4.7k; R_0805_2012Metric; MPN 0805W8F4701T5E; LCSC C17673
U301: MCP3424T-E/SL; SOIC-14_3.9x8.7mm_P1.27mm; MPN MCP3424T-E/SL; LCSC C626769
U302, U303: MCP6004T-I/SL; SOIC-14_3.9x8.7mm_P1.27mm; MPN MCP6004T-I/SL; LCSC C7378
U304: MCP6001T-I/OT; SOT-23-5; MPN MCP6001T-I/OT; LCSC C116490

Connections:
+3V3: C305.1, C306.1, C307.1, C308.1, R317.1, R319.1, R320.1, U301.6 (V_{DD}), U302.4 (V+), U303.4 (V+), U304.5 (V+); also elsewhere on the board
/Analogeingänge/ADC1+: U301.1 (CH1+), U302.1, U302.2 (-)
/Analogeingänge/ADC1-: U301.2 (CH1-), U302.6 (-), U302.7
/Analogeingänge/ADC2+: U301.3 (CH2+), U302.8, U302.9 (-)
/Analogeingänge/ADC2-: U301.4 (CH2-), U302.13 (-), U302.14
/Analogeingänge/ADC3+: U301.11 (CH3+), U303.1, U303.2 (-)
/Analogeingänge/ADC3-: U301.12 (CH3-), U303.6 (-), U303.7
/Analogeingänge/ADC4+: U301.13 (CH4+), U303.8, U303.9 (-)
/Analogeingänge/ADC4-: U301.14 (CH4-), U303.13 (-), U303.14
/Analogeingänge/AI1+: D301.2 (A2), J301.1 (1_1), J301.2 (1_2), R301.1
/Analogeingänge/AI1-: D302.2 (A2), J301.3 (2_1), J301.4 (2_2), R302.1
/Analogeingänge/AI2+: D303.2 (A2), J301.5 (3_1), J301.6 (3_2), R303.1
/Analogeingänge/AI2-: D304.2 (A2), J301.7 (4_1), J301.8 (4_2), R304.1
/Analogeingänge/AI3+: D305.2 (A2), J302.1 (1_1), J302.2 (1_2), R305.1
/Analogeingänge/AI3-: D306.2 (A2), J302.3 (2_1), J302.4 (2_2), R306.1
/Analogeingänge/AI4+: D307.2 (A2), J302.5 (3_1), J302.6 (3_2), R307.1
/Analogeingänge/AI4-: D308.2 (A2), J302.7 (4_1), J302.8 (4_2), R308.1
/Analogeingänge/I2C_SCL: R319.2, U301.8 (SCL); also elsewhere on the board
/Analogeingänge/I2C_SDA: R320.2, U301.7 (SDA); also elsewhere on the board
/Analogeingänge/VCM: R309.1, R310.1, R311.1, R312.1, R313.1, R314.1, R315.1, R316.1, U304.1, U304.4 (-)
unnamed: C301.1, R301.2, R309.2, U302.3 (+)
unnamed: C301.2, R302.2, R310.2, U302.5 (+)
unnamed: C302.1, R303.2, R311.2, U302.10 (+)
unnamed: C302.2, R304.2, R312.2, U302.12 (+)
unnamed: C303.1, R305.2, R313.2, U303.3 (+)
unnamed: C303.2, R306.2, R314.2, U303.5 (+)
unnamed: C304.1, R307.2, R315.2, U303.10 (+)
unnamed: C304.2, R308.2, R316.2, U303.12 (+)
unnamed: C309.1, R317.2, R318.1, U304.3 (+)

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
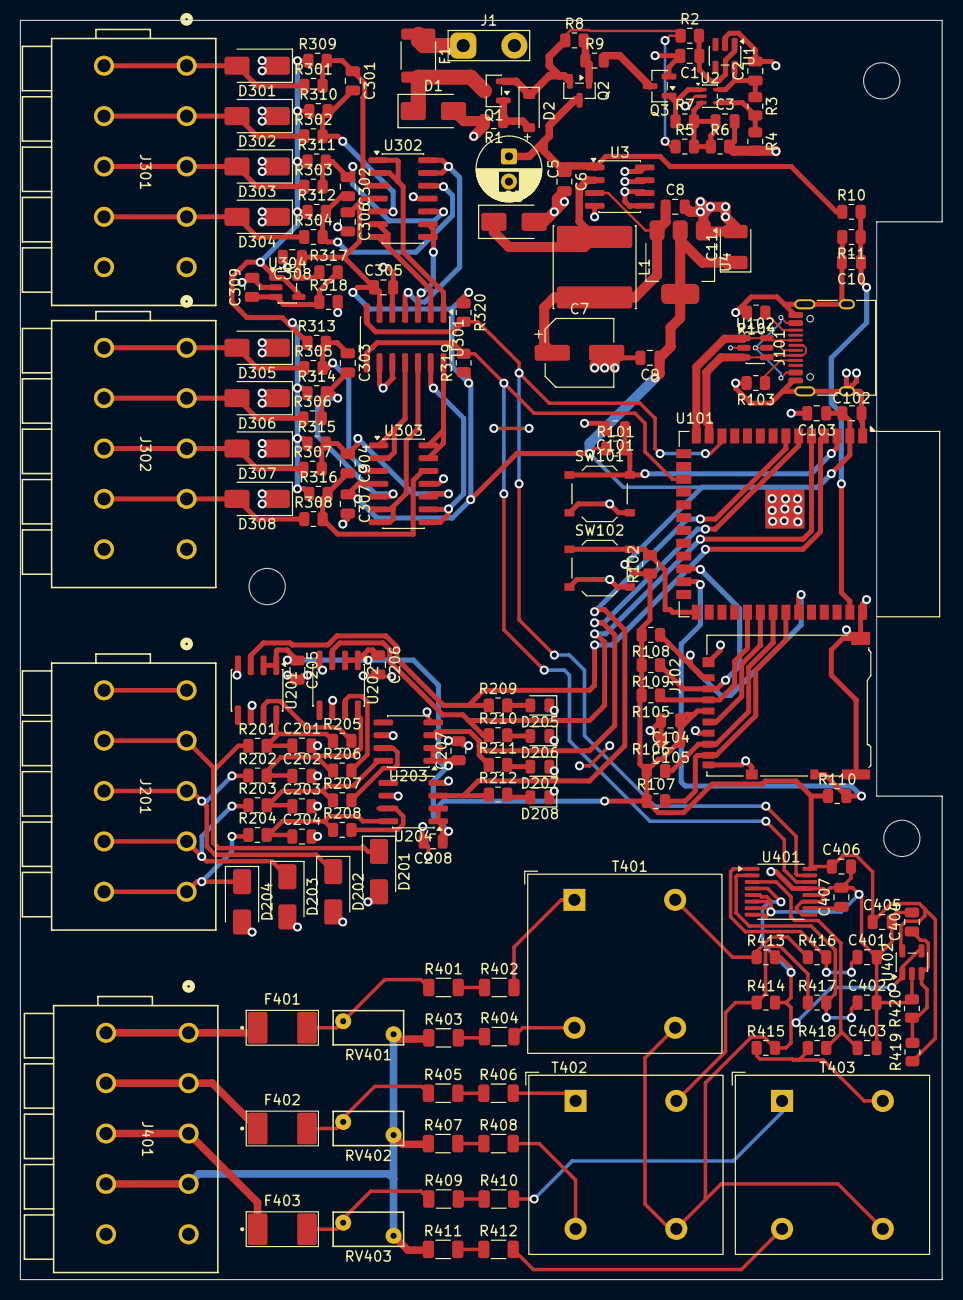
[picture p11: board Ver1.kicad_pcb from above]

Board: 2 copper layers, 91.5 x 125.0 mm, 170 parts (0 on the bottom side), 108 nets.
