JohannesKienle/Messgeraet/(commit log)

2026-07-20 Enable notifications for sample and history characteristics
2026-07-20 Refactor time selection and improve canvas interaction
    Replaced select dropdown with preset buttons for time intervals and added live button functionality. Enhanced canvas interactivity with pointer events for panning and pinch-zooming.
2026-07-22 Prevent zoom gesture on hide button click
    Add check to prevent pointerdown event from triggering zoom gesture when clicking hide button.
2026-11-12 Refactor battery status display in index.html
2026-11-12 Implement calibration panel for zero adjustment
    Added calibration panel with functionality for zero adjustment of analog inputs, including user instructions and status updates.
2026-11-12 PCB Design upload
