JohannesKienle/Messgeraet/(notices)

Notices in the files:
Hardware/Ver1/KiCADv6/2604-1105.stp:
author */ ('License CC BY-ND 4.0'),
